Vit-world/cmp170hx-water-cooling/stl/README.ru.md

# Заготовки для подбора проставки (15 × 7 мм)

[English](README.md) · **Русский** · [← назад](../README.ru.md)

Восемь простых брусков **15 × 7 мм** высотой **от 3,0 до 6,5 мм с шагом 0,5 мм**. Распечатайте их все сразу на любом 3D-принтере и подберите, какой толщины должна быть алюминиевая проставка для [места 1](../docs/fitment.ru.md#место-1-выемка-в-блоке-над-компонентом) с **вашими** термопрокладками.

| Высота | Файл |
|---|---|
| 3,0 мм | [blank_15x7x3.stl](blank_15x7x3.stl) |
| 3,5 мм | [blank_15x7x3p5.stl](blank_15x7x3p5.stl) |
| 4,0 мм | [blank_15x7x4.stl](blank_15x7x4.stl) |
| 4,5 мм | [blank_15x7x4p5.stl](blank_15x7x4p5.stl) |
| 5,0 мм | [blank_15x7x5.stl](blank_15x7x5.stl) |
| 5,5 мм | [blank_15x7x5p5.stl](blank_15x7x5p5.stl) |
| 6,0 мм | [blank_15x7x6.stl](blank_15x7x6.stl) |
| 6,5 мм | [blank_15x7x6p5.stl](blank_15x7x6p5.stl) |
| **все восемь на одной плите** (75 × 19 мм) | [blanks_plate_15x7.stl](blanks_plate_15x7.stl) |

## Как пользоваться

1. Распечатайте плиту (или отдельные бруски). Подойдёт любой FDM-принтер и любой пластик: заготовки только для примерки, карта при этом обесточена.
2. **Измерьте каждую напечатанную заготовку штангенциркулем** и ориентируйтесь на измеренную высоту: напечатанная деталь может отличаться от модели на несколько десятых миллиметра.
3. Над выемкой положите на компонент: прокладку, заготовку, прокладку, опустите блок, как при [примерке](../docs/fitment.ru.md#примерка-где-водоблок-не-касается-чипов-видеокарты), снимите и посмотрите на отпечатки. Повторите с другими заготовками и оставьте ту толщину, при которой контакт равномерный и карта не напрягается.
4. Сделайте настоящую проставку из алюминия с той же площадью и выбранной высотой и полностью изолируйте её прокладками (см. [предупреждения](../docs/fitment.ru.md#предупреждения)).

## Примечания

- Площадь 15 × 7 мм подошла к выемке в сборке автора. Сверьте с вашим блоком, прежде чем что-либо резать.
- Нужная высота зависит от ваших прокладок. Прокладки из комплекта блока в этой сборке были толщиной 1,7 мм и очень мягкие. **В сборке автора брусок 5,5 мм, сверху и снизу по прокладке 1,7 мм.**
- В исходном наборе автора были высоты 3,0–5,5 мм и 6,5 мм; здесь добавлена заготовка 6,0 мм, чтобы шаги были ровными.
- Пересоздать или сделать другие размеры: `python3 make_spacer_blanks.py --plate` (только стандартная библиотека; ключи `--length`, `--width`, `--heights` см. в `--help`).
