Vit-world/cmp170hx-water-cooling/stl/blank_15x7x6.stl

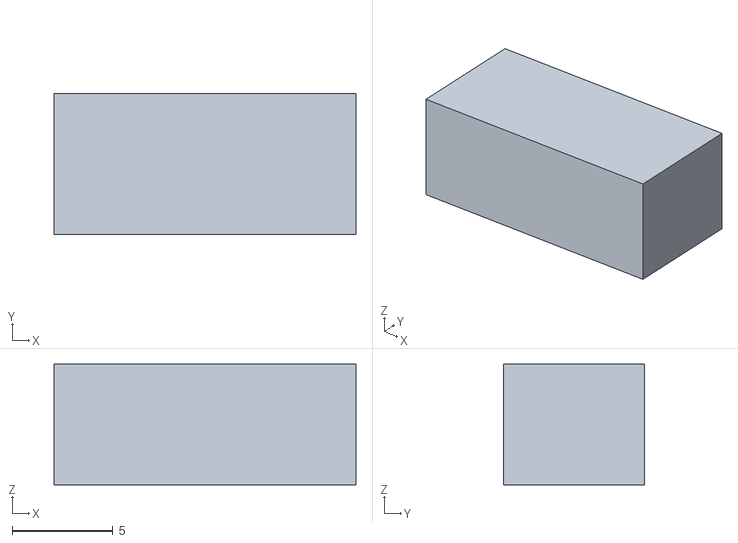
[picture p10: CAD file, 2026-10-14]
stl/blank_15x7x6.stl
15.0 x 7.00 x 6.00
