Vit-world/cmp170hx-water-cooling/stl/blank_15x7x5p5.stl

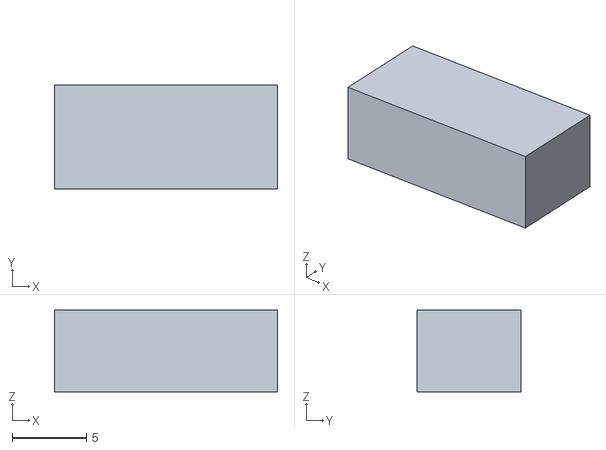
[picture p11: CAD file, 2026-10-14]
stl/blank_15x7x5p5.stl
15.0 x 7.00 x 5.50
