Vit-world/cmp170hx-water-cooling/stl/blank_15x7x3.stl

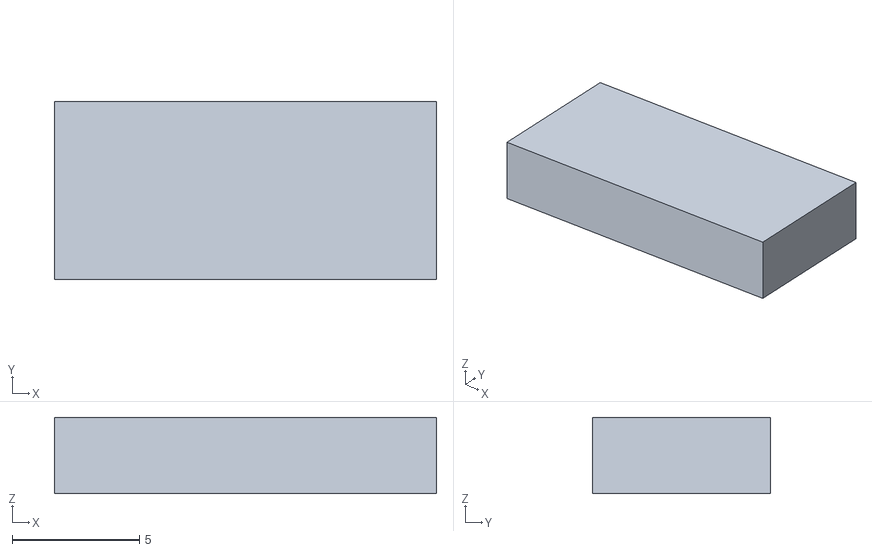
[picture p13: CAD file, 2026-10-14]
stl/blank_15x7x3.stl
15.0 x 7.00 x 3.00
