Vit-world/cmp170hx-water-cooling/stl/blanks_plate_15x7.stl

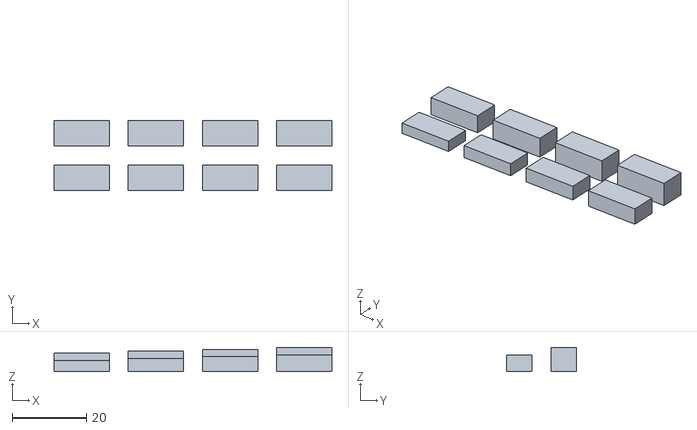
[picture p17: CAD file, 2026-10-14]
stl/blanks_plate_15x7.stl
75.0 x 19.0 x 6.50
