Vit-world/cmp170hx-water-cooling/data/04-profile-validation/cold-samples.csv

t | core | hbm | power | plimit | sm | mclk | util | vram_mb | fan | pcie_gen | pcie_w | rad_pct | rad_rpm | pump_pct | pump_rpm
0.0 | 37 | 53 | 34.94 | 250.0 | 210 | 1836 | 0 | 0 |  | 2 | 4 | 36 | 1329 | 41 | 3260
2.0 | 37 | 53 | 35.23 | 250.0 | 1140 | 1836 | 0 | 24 |  | 2 | 4 | 36 | 1339 | 41 | 3199
4.0 | 55 | 57 | 243.14 | 250.0 | 1455 | 1836 | 100 | 58416 |  | 2 | 4 | 36 | 1273 | 41 | 3221
6.0 | 56 | 59 | 248.15 | 250.0 | 1455 | 1836 | 100 | 58416 |  | 2 | 4 | 50 | 1302 | 50 | 3435
8.0 | 56 | 59 | 248.06 | 250.0 | 1455 | 1836 | 100 | 58416 |  | 2 | 4 | 50 | 1662 | 50 | 3435
10.0 | 57 | 61 | 244.58 | 250.0 | 1455 | 1836 | 100 | 58416 |  | 2 | 4 | 54 | 1787 | 50 | 3426
12.0 | 57 | 60 | 244.1 | 250.0 | 1455 | 1836 | 100 | 58416 |  | 2 | 4 | 58 | 1829 | 50 | 3400
14.0 | 57 | 60 | 244.0 | 250.0 | 1455 | 1836 | 100 | 58416 |  | 2 | 4 | 58 | 1886 | 50 | 3426
16.0 | 57 | 60 | 246.81 | 250.0 | 1455 | 1836 | 100 | 58416 |  | 2 | 4 | 58 | 1876 | 50 | 3426
18.0 | 57 | 60 | 248.78 | 250.0 | 1455 | 1836 | 100 | 58416 |  | 2 | 4 | 58 | 1871 | 50 | 3426
20.0 | 57 | 60 | 247.19 | 250.0 | 1455 | 1836 | 100 | 58416 |  | 2 | 4 | 58 | 1869 | 50 | 3435
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
