Vit-world/cmp170hx-water-cooling/data/04-profile-validation/quiet-samples.csv

t | core | hbm | power | plimit | sm | mclk | util | vram_mb | fan | pcie_gen | pcie_w | rad_pct | rad_rpm | pump_pct | pump_rpm
0.0 | 27 | 45 | 32.87 | 250.0 | 210 | 1836 | 0 | 0 |  | 2 | 4 | 92 | 2736 | 92 | 4179
2.0 | 27 | 45 | 40.14 | 250.0 | 1140 | 1836 | 0 | 24 |  | 2 | 4 | 92 | 2824 | 88 | 4179
4.0 | 44 | 49 | 250.66 | 250.0 | 1470 | 1836 | 100 | 58416 |  | 2 | 4 | 88 | 2635 | 88 | 4115
6.0 | 45 | 50 | 254.83 | 250.0 | 1485 | 1836 | 100 | 58416 |  | 2 | 4 | 84 | 2587 | 84 | 4078
8.0 | 45 | 51 | 248.92 | 250.0 | 1485 | 1836 | 100 | 58416 |  | 2 | 4 | 84 | 2564 | 84 | 4078
10.0 | 46 | 51 | 253.49 | 250.0 | 1470 | 1836 | 100 | 58416 |  | 2 | 4 | 80 | 2496 | 80 | 4005
12.0 | 46 | 52 | 249.8 | 250.0 | 1470 | 1836 | 100 | 58416 |  | 2 | 4 | 76 | 2416 | 76 | 3935
14.0 | 46 | 52 | 243.61 | 250.0 | 1485 | 1836 | 100 | 58416 |  | 2 | 4 | 76 | 2345 | 76 | 3935
16.0 | 46 | 52 | 238.36 | 250.0 | 1470 | 1836 | 100 | 58416 |  | 2 | 4 | 73 | 2252 | 73 | 3879
18.0 | 47 | 52 | 257.17 | 250.0 | 1485 | 1836 | 100 | 58416 |  | 2 | 4 | 69 | 2190 | 69 | 3792
20.0 | 47 | 52 | 252.43 | 250.0 | 1485 | 1836 | 100 | 58416 |  | 2 | 4 | 69 | 2164 | 69 | 3824
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
