Vit-world/cmp170hx-water-cooling/(commit log)

2026-10-14 CMP 170HX water-loop calibration: data, scripts and wiki proposal
    Pump and radiator-fan duty vs temperature at 250 W on one water loop, HBM temperature
    floor, subjective noise ranking, two validated fan-curve profiles, a cooling daemon and the
    calibration runner, plus the text proposed for the community wiki (wiki-pr/).
    [cold-samples.csv, quiet-samples.csv, samples.csv]
2026-10-14 Restructure as a water-cooling install guide: fitment notes, photos, pad map; calibration moved to docs/
    - README (English, Russian) as the landing page with a language switcher
    - docs/fitment{,.ru}.md: air-cooled background, the rule for choosing pads, two spots the block
    does not reach, the aluminium spacer method, pad-to-boss map, Kapton insulation, warnings
    - images/: seven photos (metadata stripped) and the annotated pad map
    - docs/calibration.md: the previous README content
2026-10-14 Уточнить текст и исправить ошибки в документации
    Исправлены незначительные ошибки в тексте и уточнены формулировки для большей ясности.
2026-10-14 Обновить разделы о термопрокладках и установке
    Обновлены разделы о термопрокладках, добавлены уточнения о материалах и методах установки. Исправлены формулировки для большей ясности.
2026-10-14 fitment: photo for Spot 2, mirror the Russian edits into the English page, 8-photo gallery
    - add the Spot 2 photo (small IC and the flat area above it) to both languages
    - mirror the Russian wording edits: air is drawn from inside the PC case, 2 x 1.7 mm pads for Spot 2,
    multimeter check for non-conductive pads, renamed map and soft-pads headings
    - README galleries: eight photos, anchors updated to the renamed headings
2026-10-14 Add printable spacer test blanks (15 x 7 mm, 3.0-6.5 mm in 0.5 mm steps)
    Eight plain blocks plus one plate file with all of them, a small generator script, and how-to pages
    in English and Russian; linked from the fitment pages and the landing pages.
    [blank_15x7x3.stl, blank_15x7x3p5.stl, blank_15x7x4.stl, blank_15x7x4p5.stl, blank_15x7x5.stl, blank_15x7x5p5.stl, blank_15x7x6.stl, blank_15x7x6p5.stl]
2026-10-14 Обновить раздел о подборе толщины бруска
    Добавлены уточнения по подбору толщины бруска и термопасты.
2026-10-14 Обновить раздел результатов с текущими показателями
    Добавлены текущие температуры и скорости вентиляторов в разделе результатов. Обновлены формулировки для ясности.
2026-10-14 Добавлено состояние системы в раздел установки
    Добавлено текущее состояние температуры и потребления.
2026-10-14 Mirror the Russian edits into the English pages; update anchors to the renamed headings
    - English: renamed Test fit / Spot 1 / Spot 2 headings, bar thickness (5.5 mm + 2 x 1.7 mm pads),
    masking-tape and thermal-paste notes, state of the system, revised results and limits
    - Russian: fix a typo, blank lines between the new paragraphs, trim the to-do list
    - stl notes: the author's final bar height; all anchor links updated
2026-10-14 ru: "процессор" -> "ядро GPU" where the card's chip is meant
